DarkZeros/LightInk/hardware/case/CASE.md

# Case Design 

The case started from a reference case from: https://www.printables.com/model/502517-watchy-case-with-low-profile-buttons/collections
Thanks for that reference design!

I took it and edited on top:
  - Removed the screw holes
  - Shifted the display UP in order to have a even space in the border around display
    - This required removing the watchy PCB arches on top/bottom
  - Make a new square hole for the solar panel
  - Removed the buttons, instead add M1 holes for screws
  - Make more space inside the case by reducing the supports and the reducing size
  - Many other small changes

# Versions

I uploaded all the versions I have saved, though I recomend the V14 for production.
I have access to all the history in onShape. [OnShape Link](https://cad.onshape.com/documents/3c40abaf85090b07c79fcd27/w/1896b3b0cd361c4ac062c341/e/53d3942db51d4a936ae92a33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)

# Important things

The case needs to be UV resistent. If the material is not, then will quickly turn YELLOW.
I used SLA resin and Nylon, and those did not degrade, but other materials probably will.

(ADD picture here of how much it degrades to yellow)

## What is it?

It just tries to keep all the watch inside. Thats it. It doesn´t try to
be amazing or fancy. take it as reference, if you want you can build another one or edit in place small things.

# How to print

I used JLCPCB service to print, since I do not have a good enough 3D printed.
The order was: 
- SLA(Resin) 
- Imagine Black 
- Sanding general

Also I did try this other one for White colour:
- SLS(Nylon) 
- 1172Pro Nylon 
- White 
- No surface finish
