DarkZeros/LightInk/hardware/pcb/kicad/V5.kicad_pcb

## KiCad design hardware/pcb/kicad/V5.kicad_pcb (2026-11-06)

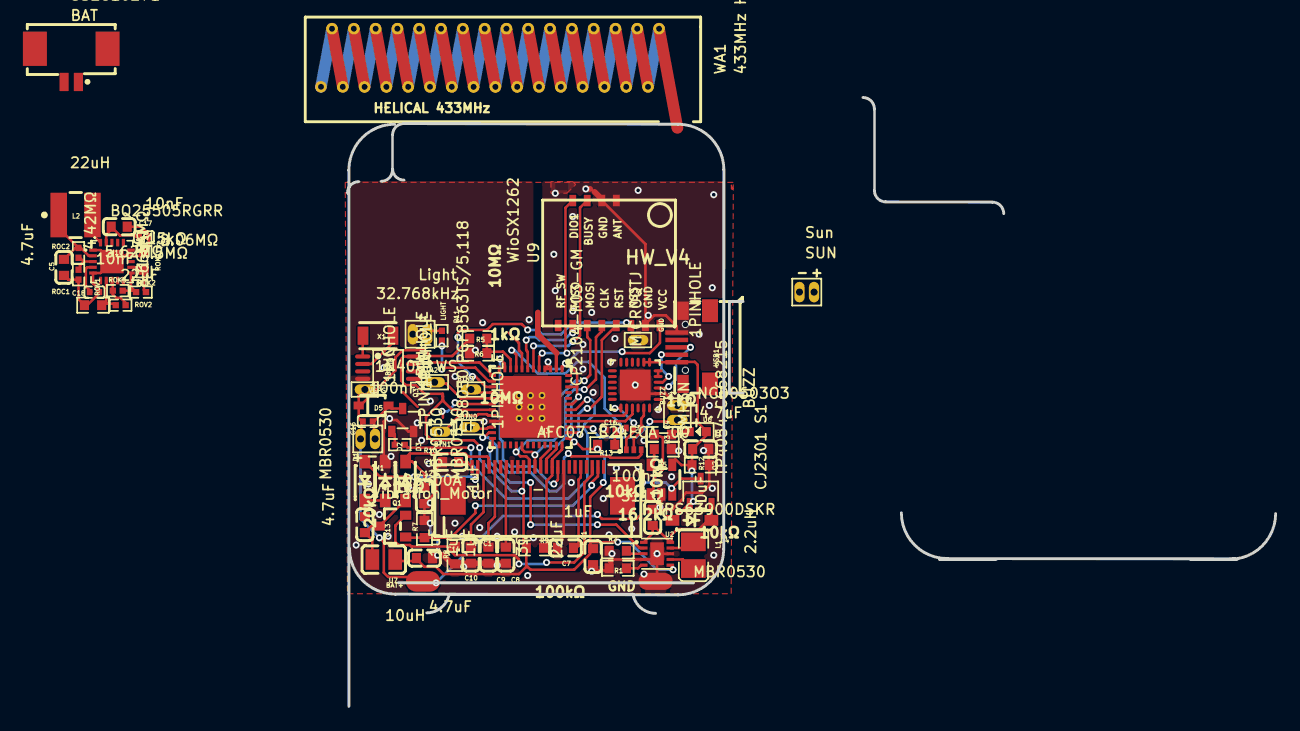
[picture p3: board V5.kicad_pcb from above]

Board: 2 copper layers, 81.1 x 53.2 mm, 75 parts (1 on the bottom side), 68 nets.

Parts:
+BAT: 1PINHOLE
AE1: SWRA117D
BAT: 532610271; CONN-SMD_532610271
BTN0, BTN1, BTN2, BTN3: 1PINHOLE
BUZZ: BUZZ; VIBRATING-MOTOR-SMD_WELDING
C1, C17: 22uF; C0603
C2: 10uF; C0603
C5, C6, C13, C14: 4.7uF; C0603
C7, C8, C9, C10, C11, C12: 1uF; C0603
C15, C16: 100nF; C0402
C18, C19: 10nF; C0402
D1, D2, D3, D4: MBR0530; SOD-123_L2.7-W1.6-LS3.7-RD-1
D5: 1N4001WS; SOD-323_L1.6-W1.3-LS2.7-RD
FPC1: AFC07-S24ECA-00; FPC-SMD_AFC07-S24ECA-00
GND: 1PINHOLE
L1: 2.2uH; L1008
L2: 22uH; IND-SMD_L3.9-W3.9-1
LIGHT: Light; VIBRATING-MOTOR-SMD_WELDING
M1: Vibration_Motor; VIBRATING-MOTOR-SMD_WELDING
Pad_gge46144: Pad_gge46144
Pad_gge46189: Pad_gge46189
Q1: AO3400A; SOT-23_L2.9-W1.3-P1.90-LS2.4-BR
Q2: CJ2301 S1; SOT-23-3_L3.0-W1.7-P0.95-LS2.9-BR
Q3: S8050; SOT-23-3_L2.9-W1.3-P1.90-LS2.4-BR
Q4: UMH3N; SC-70-6_L2.2-W1.3-P0.65-LS2.1-BR
R1: 16.2kΩ; R0603
R2: 511Ω; R0603
R3, R12, R13: 10kΩ; R0603
R4: 1kΩ; R0603
R5, R6: 10MΩ; R0603
R7: 20kΩ; R0603
R8: 3Ω; R0603
R9: 100kΩ; R0603
R10, R11: 1kΩ; R0402
ROC1: 8.66MΩ; R0402
ROC2: 1.54MΩ; R0402
ROK1: 4.42MΩ; R0603
ROK2: 8.06MΩ; R0402
ROK3: 715kΩ; R0402
ROV1: 5.62MΩ; R0603
ROV2: 7.5MΩ; R0402
SUN: Sun; VIBRATING-MOTOR-SMD_WELDING
U2: TPS63900DSKR; WSON-10_L2.5-W2.5-W0.50-TL-EP
U3: -; LGA-48_L7.0-W7.0-P0.50-BL-EP5.4
U4: CP2104-F03-GM; QFN-24_L4.0-W4.0-P0.50-BL-EP2.7
U5: TP4054_C668215; TSOT-23-5_L2.9-W1.6-P0.95-LS2.8-BR
U6: NCD0603O3; LED0603-RD
U7: 10uH; L0806
U8: PCF8563TS/5,118; TSSOP-8_L3.0-W3.0-P0.65-LS4.9-BL
U9: WioSX1262; SEEED_WIO_SX1262_PINS
U10: BQ25505RGRR; VQFN-20_L3.5-W3.5-P0.50-TL-EP
USB1: MICROQTJ; MICRO-USB-SMD_MICROQTJ
WA1: 433MHz Helical Antenna; 433MHZ HELICAL ANTENNA
X1: 32.768kHz; CRYSTAL-SMD_L3.2-W1.5

Connections:
32KHZ: U3.13, U8.7
+3V3: C1.2, C14.2, FPC1.9, FPC1.10, R9.2, R13.2, U2.6, U3.1, U3.3, U3.4, U3.19, U3.37, U3.43, U3.46, U7.1, U8.8, U9.8
+BAT: +BAT.1, BAT.1, C15.1, D5.1, M1.2, Pad_gge46189.2, Q2.3, R5.1, SUN.2, U5.3, U10.18
+SOL: C5.2, L2.1, ROC2.1, U10.2
AE1_1: AE1.1, U3.2
BAT: R5.2, R6.1, U3.10
BTN0: BTN0.1, U3.22
BTN1: BTN1.1, U3.20
BTN2: BTN2.1, U3.17
BTN3: BTN3.1, U3.16
BUSY: FPC1.16, U3.11
BUZZ: BUZZ.2, U3.39
C7_2: C7.2, FPC1.20
C8_2: C8.2, FPC1.7
C9_2: C9.2, FPC1.5
C10_2: C10.2, FPC1.3
C11_2: C11.2, FPC1.1
D1_1: C13.2, D1.1, D2.2
D3_2: C13.1, D3.2, Q1.3, U7.2
D+: U4.3, USB1.3
D-: U4.4, USB1.2
DC: FPC1.14, U3.35
DIO1: U3.5, U9.12
DTR: Q4.2, Q4.4, U4.23
EN: C16.1, Q4.6, R13.1, U3.9
GDR: FPC1.23, Q1.1, R7.1
GH: C12.1, D3.1, FPC1.4
GL: D1.2, FPC1.2
GND: AE1.2, BAT.2, BUZZ.1, C1.1, C2.1, C5.1, C6.2, C7.1, C8.1, C9.1, C10.1, C11.1, C12.2, C14.1, C16.2, C17.1, C18.2, C19.2, D2.1, FPC1.8, FPC1.17, GND.1, LIGHT.1, Pad_gge46144.2, Q3.2, R1.1, R2.1, R3.1, R6.2, R7.2, R8.2, R12.1, ROC1.2, ROK1.2, ROV1.1, SUN.1, U2.4, U2.8, U2.11, U3.21, U3.49, U4.2, U4.25, U5.2, U8.4, U9.7, U9.10, U10.1, U10.5, U10.14, U10.15, U10.21, USB1.5
GPIO0: Q4.3, U3.23
L2_2: L2.2, U10.20
LIGHT: R11.2, U3.14
LIGHT_2: LIGHT.2, R11.1
LORABUSY: U3.6, U9.11
LORACS: U3.15, U9.6
LORARES: U3.38, U9.5
MISO: U3.7, U9.2
MOSI: FPC1.11, U3.28, U9.3
Q3_1: Q3.1, R10.2
Q3_3: C15.2, D5.2, M1.1, Q3.3
R4_2: R4.2, U6.1
RES: FPC1.15, R9.1, U3.36
RESE: FPC1.22, Q1.2, R8.1
RTS: Q4.1, Q4.5, U4.19
RX: U3.40, U4.21
SCK: FPC1.12, U3.29, U9.4
SS: FPC1.13, U3.34
TX: U3.41, U4.20
U2_1: C2.2, D4.1, Q2.2, U2.1, U2.10
U2_3: R2.2, U2.3
U2_5: R1.2, U2.5
U2_7: L1.2, U2.7
U2_9: L1.1, U2.9
U4_5: U4.5, U4.6
U5_1: R4.1, U5.1
U5_5: R3.2, U5.5
U10_3: ROC1.1, ROC2.2, U10.3
U10_4: C18.1, U10.4
U10_7: ROV1.2, ROV2.1, U10.7
U10_8: ROK3.1, ROV2.2, U10.8
U10_11: ROK2.1, ROK3.2, U10.11
U10_12: ROK1.1, ROK2.2, U10.12
U10_19: C17.2, C19.1, U10.19
VBUS: C6.1, D4.2, Q2.1, R12.2, U4.7, U4.8, U5.4, U6.2, USB1.1
VIB: R10.1, U3.42
VSEL: U2.2, U3.24
XN: U8.2, X1.2
XP: U8.1, X1.1
