DarkZeros/LightInk/firmware/main/peripherals.cpp

#include "peripherals.h"
#include "hardware.h"
#include "notes.h"
#include "power.h"
#include "touch.h"
#include "trace.h"

#include <mutex>

#include "driver/gpio.h"
#include "Arduino.h"

void Peripherals::vibrator(const std::vector<int>& pattern) {
  constexpr const gpio_config_t kConf = {
    .pin_bit_mask = (1ULL<<HW::kVibratorPin),
    .mode = GPIO_MODE_OUTPUT,
    .pull_up_en = GPIO_PULLUP_DISABLE,
    .pull_down_en = GPIO_PULLDOWN_DISABLE,
    .intr_type = GPIO_INTR_DISABLE,
  };

  //Configure GPIO with the given settings
  gpio_config(&kConf);
  Trace::vibrator(pattern);

  for(auto i = 0; i < pattern.size(); i++) {
    gpio_set_level((gpio_num_t)HW::kVibratorPin, i % 2 ? 0 : 1);
    delay(pattern[i]);
  }
  gpio_set_level((gpio_num_t)HW::kVibratorPin, 0);
}

#include "driver/ledc.h"
#include "soc/ledc_struct.h"
#include "soc/rtc_cntl_reg.h"

struct Speaker {
  constexpr static auto kTimer = LEDC_TIMER_0;
  constexpr static auto kChannel = LEDC_CHANNEL_0;
  constexpr static auto kSpeedMode = LEDC_LOW_SPEED_MODE;
  constexpr static auto kClock = LEDC_USE_RC_FAST_CLK;

  // One sound at a time: a second Speaker would retune the timer of the first one and
  // stop it when it ends. A sound that starts meanwhile plays after it, like the beep
  // of a button and then what its action plays
  static inline std::mutex sPlaying;
  std::lock_guard<std::mutex> playing{sPlaying};

  Power::Lock powerLock = Power::Lock(Power::Flag::Speaker);

  // RC_FAST stays powered in light sleep (CK8M_FORCE_PU), but the RTC state machine still
  // gates it to the digital side for its 8M wait on every sleep transition. The LEDC then
  // stalls for ~0.1 ms and the tone clicks (pitch -1.3%, level -21% through a filter, in
  // a recording). IDF sets FORCE_NOGATING with FORCE_PU on C2/C3, not on ESP32/S3, and
  // never writes the bit there, so it holds while set. Counted, sounds can overlap
  struct NoClockGating {
    static inline std::atomic<int> sUsers{0};
    NoClockGating() {
      if (sUsers.fetch_add(1) == 0)
        SET_PERI_REG_MASK(RTC_CNTL_CLK_CONF_REG, RTC_CNTL_CK8M_FORCE_NOGATING);
    }
    ~NoClockGating() {
      if (sUsers.fetch_sub(1) == 1)
        CLEAR_PERI_REG_MASK(RTC_CNTL_CLK_CONF_REG, RTC_CNTL_CK8M_FORCE_NOGATING);
    }
  } noClockGating;

  // On the PICO-D4 the touch FSM measurement stalls the tone too, so touch is
  // measured in between notes, in the silence before each one starts (set())
  Touch::Manual touchManual;

  // Select resolution based on the frequency values, not to overflow or underflow divisor
  static ledc_timer_bit_t calc_resolution(uint32_t freq) {
    if (freq < 64) return LEDC_TIMER_10_BIT;
    if (freq < 128) return LEDC_TIMER_9_BIT;
    if (freq < 256) return LEDC_TIMER_8_BIT;
    if (freq < 512) return LEDC_TIMER_7_BIT;
    if (freq < 1024) return LEDC_TIMER_6_BIT;
    if (freq < 2 * 1024) return LEDC_TIMER_5_BIT;
    if (freq < 4 * 1024) return LEDC_TIMER_4_BIT;
    if (freq < 8 * 1024) return LEDC_TIMER_3_BIT;
    if (freq < 16 * 1024) return LEDC_TIMER_2_BIT;
    return LEDC_TIMER_1_BIT;
  }

  Speaker() {
    // Enable light sleep while Speaker active
    esp_sleep_pd_config(ESP_PD_DOMAIN_RC_FAST, ESP_PD_OPTION_ON);
    gpio_sleep_sel_dis((gpio_num_t)HW::kSpeakerPin);

    // Set up channel config, never changes
    constexpr ledc_channel_config_t ledc_channel = {
        .gpio_num = (gpio_num_t)HW::kSpeakerPin,
        .speed_mode = kSpeedMode,
        .channel = kChannel,
        .intr_type = LEDC_INTR_DISABLE,
        .timer_sel = kTimer,
        .duty = 0,
        .hpoint = 0,
        .sleep_mode = LEDC_SLEEP_MODE_KEEP_ALIVE,
        .flags = {
          .output_invert = 0,
        },
        .deconfigure = false,
    };
    ledc_channel_config(&ledc_channel);

    // ledc_timer_config_t ledc_timer = {
    //   .speed_mode = kSpeedMode,
    //   .duty_resolution = LEDC_TIMER_2_BIT, // calc_resolution(freq),
    //   .timer_num = kTimer,
    //   .freq_hz = 0, // Set output frequency
    //   .clk_cfg = kClock,
    //   .deconfigure = false,
    // };
    // ledc_timer_config(&ledc_timer);
  }
  ~Speaker() {
    stop();
    esp_sleep_pd_config(ESP_PD_DOMAIN_RC_FAST, ESP_PD_OPTION_AUTO);
  }

  void set(uint32_t freq) {
    if (freq == 0) {
      stop();
      return;
    }
    // Update timer + duty
    const auto dutyBit = calc_resolution(freq);
    uint32_t halfDuty = 1 << (dutyBit - 1);

    ledc_stop(kSpeedMode, kChannel, 0);  // Clear duty_start / sig_out_en first
    Touch::measureNow();                 // While silent, see touchManual

    ledc_timer_config_t ledc_timer = {
      .speed_mode = kSpeedMode,
      .duty_resolution = dutyBit,
      .timer_num = kTimer,
      .freq_hz = freq, // Set output frequency
      .clk_cfg = kClock,
      .deconfigure = false,
    };
    ledc_timer_config(&ledc_timer);

    // // ledc_set_freq(kSpeedMode, kTimer, freq);
    // ledc_set_duty(kSpeedMode, kChannel, halfDuty);
    // ledc_update_duty(kSpeedMode, kChannel);
    // // ledc_ls_channel_update(kSpeedMode, kChannel);
    // // ledc_hal_ls_channel_update(&(p_ledc_obj[kSpeedMode]->ledc_hal), channel);

    // // ledc_set_freq(kSpeedMode, kTimer, freq);
    // // ledc_set_duty_and_update(kSpeedMode, kChannel, halfDuty, 0);

    // Directly write registers, bypassing the duty_start spin-wait
    LEDC.channel_group[kSpeedMode].channel[kChannel].duty.duty = halfDuty << 4;
    LEDC.channel_group[kSpeedMode].channel[kChannel].conf0.sig_out_en = 1;
    LEDC.channel_group[kSpeedMode].channel[kChannel].conf1.duty_inc = 1;
    LEDC.channel_group[kSpeedMode].channel[kChannel].conf1.duty_num = 1;
    LEDC.channel_group[kSpeedMode].channel[kChannel].conf1.duty_cycle = 1;
    LEDC.channel_group[kSpeedMode].channel[kChannel].conf1.duty_scale = 0;
    // Trigger low-speed channel update (no spin-wait)
    LEDC.channel_group[kSpeedMode].channel[kChannel].conf0.low_speed_update = 1;
  }

  void stop() {
    ledc_stop(kSpeedMode, kChannel, 0);
  }
};

void Peripherals::speaker(const std::vector<std::pair<int, int>>& pattern) {
  Speaker speaker;
  Trace::speaker(pattern);

  for(auto& [note, duration] : pattern) {
    speaker.set(note);
    delay(duration);
  }
}



// change this to make the song slower or faster
int tempo=144; 

// change this to whichever pin you want to use
int buzzer = 11;

// notes of the moledy followed by the duration.
// a 4 means a quarter note, 8 an eighteenth , 16 sixteenth, so on
// !!negative numbers are used to represent dotted notes,
// so -4 means a dotted quarter note, that is, a quarter plus an eighteenth!!
int melody[] = {

  //Based on the arrangement at https://www.flutetunes.com/tunes.php?id=192
  
  NOTE_E5, 4,  NOTE_B4,8,  NOTE_C5,8,  NOTE_D5,4,  NOTE_C5,8,  NOTE_B4,8,
  NOTE_A4, 4,  NOTE_A4,8,  NOTE_C5,8,  NOTE_E5,4,  NOTE_D5,8,  NOTE_C5,8,
  NOTE_B4, -4,  NOTE_C5,8,  NOTE_D5,4,  NOTE_E5,4,
  NOTE_C5, 4,  NOTE_A4,4,  NOTE_A4,8,  NOTE_A4,4,  NOTE_B4,8,  NOTE_C5,8,

  NOTE_D5, -4,  NOTE_F5,8,  NOTE_A5,4,  NOTE_G5,8,  NOTE_F5,8,
  NOTE_E5, -4,  NOTE_C5,8,  NOTE_E5,4,  NOTE_D5,8,  NOTE_C5,8,
  NOTE_B4, 4,  NOTE_B4,8,  NOTE_C5,8,  NOTE_D5,4,  NOTE_E5,4,
  NOTE_C5, 4,  NOTE_A4,4,  NOTE_A4,4, REST, 4,

  NOTE_E5, 4,  NOTE_B4,8,  NOTE_C5,8,  NOTE_D5,4,  NOTE_C5,8,  NOTE_B4,8,
  NOTE_A4, 4,  NOTE_A4,8,  NOTE_C5,8,  NOTE_E5,4,  NOTE_D5,8,  NOTE_C5,8,
  NOTE_B4, -4,  NOTE_C5,8,  NOTE_D5,4,  NOTE_E5,4,
  NOTE_C5, 4,  NOTE_A4,4,  NOTE_A4,8,  NOTE_A4,4,  NOTE_B4,8,  NOTE_C5,8,

  NOTE_D5, -4,  NOTE_F5,8,  NOTE_A5,4,  NOTE_G5,8,  NOTE_F5,8,
  NOTE_E5, -4,  NOTE_C5,8,  NOTE_E5,4,  NOTE_D5,8,  NOTE_C5,8,
  NOTE_B4, 4,  NOTE_B4,8,  NOTE_C5,8,  NOTE_D5,4,  NOTE_E5,4,
  NOTE_C5, 4,  NOTE_A4,4,  NOTE_A4,4, REST, 4,
  

  NOTE_E5,2,  NOTE_C5,2,
  NOTE_D5,2,   NOTE_B4,2,
  NOTE_C5,2,   NOTE_A4,2,
  NOTE_GS4,2,  NOTE_B4,4,  REST,8, 
  NOTE_E5,2,   NOTE_C5,2,
  NOTE_D5,2,   NOTE_B4,2,
  NOTE_C5,4,   NOTE_E5,4,  NOTE_A5,2,
  NOTE_GS5,2,

};

// Cancel is only checked between notes: each wake in the middle of a note glitches it
// (light sleep exit and entry bend pitch and level for a few ms)
void Peripherals::tetris(const Cancel& cancel) {
  Speaker speaker;
  int notes=sizeof(melody)/sizeof(melody[0])/2; 

  // this calculates the duration of a whole note in ms (60s/tempo)*4 beats
  int wholenote = (60000 * 4) / tempo;

  int divider = 0, noteDuration = 0;
  for (int thisNote = 0; thisNote < notes * 2 && !cancel; thisNote = thisNote + 2) {

    // calculates the duration of each note
    divider = melody[thisNote + 1];
    if (divider > 0) {
      // regular note, just proceed
      noteDuration = (wholenote) / divider;
    } else if (divider < 0) {
      // dotted notes are represented with negative durations!!
      noteDuration = (wholenote) / abs(divider);
      noteDuration *= 1.5; // increases the duration in half for dotted notes
    }

    // we only play the note for 90% of the duration, leaving 10% as a pause
    speaker.set(melody[thisNote]);
    delay(noteDuration * 0.9);

    speaker.set(0);
    delay(noteDuration * 0.1);
  }
}
