DarkZeros/LightInk/firmware/main/icons.h

// 'battery', 37x21px
const unsigned char battery [] PROGMEM = {
	0x3f, 0xff, 0xff, 0xff, 0x80, 0x7f, 0xff, 0xff, 0xff, 0xc0, 0xff, 0xff, 0xff, 0xff, 0xe0, 0xe0,
	0x00, 0x00, 0x00, 0xe0, 0xe0, 0x00, 0x00, 0x00, 0xe0, 0xe0, 0x00, 0x00, 0x00, 0xf8, 0xe0, 0x00,
	0x00, 0x00, 0xf8, 0xe0, 0x00, 0x00, 0x00, 0x38, 0xe0, 0x00, 0x00, 0x00, 0x38, 0xe0, 0x00, 0x00,
	0x00, 0x38, 0xe0, 0x00, 0x00, 0x00, 0x38, 0xe0, 0x00, 0x00, 0x00, 0x38, 0xe0, 0x00, 0x00, 0x00,
	0x38, 0xe0, 0x00, 0x00, 0x00, 0x38, 0xe0, 0x00, 0x00, 0x00, 0xf8, 0xe0, 0x00, 0x00, 0x00, 0xf8,
	0xe0, 0x00, 0x00, 0x00, 0xe0, 0xe0, 0x00, 0x00, 0x00, 0xe0, 0xff, 0xff, 0xff, 0xff, 0xe0, 0x7f,
	0xff, 0xff, 0xff, 0xc0, 0x3f, 0xff, 0xff, 0xff, 0x80
};
// 'bluetooth', 13x21px
const unsigned char bluetooth [] PROGMEM = {
	0x1f, 0xc0, 0x3f, 0xe0, 0x7f, 0xf0, 0xfd, 0xf8, 0xfc, 0xf8, 0xfc, 0x78, 0xdd, 0x38, 0xcd, 0x98,
	0xe5, 0x38, 0xf0, 0x78, 0xf8, 0xf8, 0xf8, 0xf8, 0xf0, 0x78, 0xe5, 0x38, 0xcd, 0x98, 0xfd, 0x38,
	0xfc, 0x78, 0xfc, 0xf8, 0x7d, 0xf0, 0x3f, 0xe0, 0x1f, 0xc0
};
// 'celsius', 26x20px
const unsigned char celsius [] PROGMEM = {
	0x3f, 0x80, 0x1f, 0xc0, 0x7f, 0xc0, 0x3f, 0xc0, 0xc0, 0x60, 0x60, 0x00, 0xc0, 0x60, 0x60, 0x00,
	0xc0, 0x60, 0x60, 0x00, 0xc0, 0x60, 0x60, 0x00, 0xc0, 0x60, 0x60, 0x00, 0xc0, 0x60, 0x60, 0x00,
	0xc0, 0x60, 0x60, 0x00, 0xff, 0xc0, 0x40, 0x00, 0x7f, 0x80, 0x00, 0x00, 0x00, 0x00, 0x60, 0x00,
	0x00, 0x00, 0x60, 0x00, 0x00, 0x00, 0x60, 0x00, 0x00, 0x00, 0x60, 0x00, 0x00, 0x00, 0x60, 0x00,
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
};


// #include "comp.h"

// constexpr std::array input = {0x12, 0x34, 0x56};
// static_assert(RLE1B<input>::view.size() == 3);


// static_assert(RLE1B<wifioff2>::view.size() == wifioff2.size());

// static_assert(RLETestA<wifioff2>::view.size() == wifioff2.size());
