DarkZeros/LightInk/firmware/main/touch.cpp

#include "touch.h"
#include "deep_sleep.h"
#include "power.h"

#include "soc/rtc.h"

#include "hal/touch_sensor_legacy_hal.h"
#include "driver/touch_sensor.h"
#include "esp_sleep.h"
#include "esp_timer.h"

#include <atomic>
#include <optional>

namespace {
  RTC_DATA_ATTR bool mInitialized {false};
  // Last configuration applied to the HW, to skip redundant setups
  struct Applied {
    bool onlyMenuLight;
    MeasureCycles cycles;
    MeasureRate rate;
    int8_t sensitivity;
    std::array<uint8_t, 4> map;
    bool operator==(const Applied&) const = default;
  };
  RTC_DATA_ATTR std::optional<Applied> mApplied {};

  // Time between two timer measurements at a rate, _1s is one second
  constexpr uint32_t intervalMs(MeasureRate rate) { return rate * 1000 / MeasureRate::_1s; }
};

Touch::Touch(TouchSettings& settings) : mSettings{settings} {
};

void Touch::initialize() {
  touch_pad_init();
  touch_pad_set_voltage(TOUCH_HVOLT_2V4, TOUCH_LVOLT_0V5, TOUCH_HVOLT_ATTEN_1V);

  // Touching increases "C" reducing the measure
  // touch_pad_set_trigger_mode(TOUCH_TRIGGER_BELOW); // By default
  // touch_pad_intr_enable();
  // touch_pad_denoise_disable();
  touch_pad_set_fsm_mode(TOUCH_FSM_MODE_TIMER);
#if (HW_VERSION >= 10)
  touch_pad_fsm_start();
#endif

  for (auto p : HW::Touch::Pad) {
    auto pad = (touch_pad_t)p;
#if(HW_VERSION < 10)
    touch_pad_config(pad, 0);
#else
    touch_pad_config(pad);
    touch_ll_set_threshold(pad, 100000);
    touch_pad_sleep_channel_enable(pad, false); // We should not set sleep pads
#endif
  }
}

void Touch::setUp(bool onlyMenuLight) {
  if (!mInitialized) {
    mInitialized = true;
    initialize();
  }
#if(HW_VERSION >= 10)
  esp_sleep_pd_config(ESP_PD_DOMAIN_RTC_PERIPH, ESP_PD_OPTION_ON);
#endif

  const auto rate = mSettings.mRate[onlyMenuLight];
  const Applied applied{onlyMenuLight, mSettings.mCycles[onlyMenuLight], rate, mSettings.mSensitivity, mSettings.mMap};
  if (mApplied == applied)
    return;
  mApplied = applied;

#if(HW_VERSION < 10)
  touch_ll_set_meas_time(mSettings.mCycles[onlyMenuLight] * 1024);
  touch_pad_set_measurement_interval(intervalMs(rate) * 32768 / 1000); // RTC slow cycles
#else
  touch_ll_set_meas_times(mSettings.mCycles[onlyMenuLight] * 1024);
  touch_pad_set_measurement_interval((4 * 1024) / MeasureRate::_1s * rate); //???
#endif

  auto setTouchPad = [&](auto&& v, bool enabled) {
    auto pad = (touch_pad_t)HW::Touch::Pad[mSettings.mMap[v]];
#if(HW_VERSION < 10)
    // The count grows with the measure time, so the threshold scales with it. The
    // sensitivity is for one cycle unit (_31ms). The rate does not change the count
    uint16_t th = enabled ? mSettings.mSensitivity * mSettings.mCycles[onlyMenuLight] : 0;
    touch_pad_clear_group_mask((1 << pad), (1 << pad), (1 << pad));
    if (enabled)
       touch_pad_set_group_mask((1 << pad), (1 << pad), (1 << pad));
#else
    uint16_t th = enabled ? 100 : 1000000;
#endif
    touch_ll_set_threshold(pad, th);
    // ESP_LOGE("setup", "%d, %d", pad, th);
  };
  setTouchPad(HW::Touch::BotR, !onlyMenuLight);
  setTouchPad(HW::Touch::TopR, !onlyMenuLight); 
  setTouchPad(HW::Touch::TopL, true);
  setTouchPad(HW::Touch::BotL, true);

  kDSState.lightPad = HW::Touch::Pad[mSettings.mMap[HW::Touch::BotL]];
}

namespace {
  std::atomic<int> sManualUsers{0};
  std::atomic<uint32_t> sLastMeasureMs{0};

  uint32_t nowMs() { return esp_timer_get_time() / 1000; }
  // Interval of the rate setUp() applied, measureNow() keeps to it. 0 before any setUp()
  uint32_t appliedIntervalMs() { return mApplied ? intervalMs(mApplied->rate) : 0; }
}

Touch::Manual::Manual() {
#if (HW_VERSION < 10)
  // The driver call, not the LL one: on ESP32 it also stops the touch timer
  // (touch_slp_timer_en). With only the mode switched the timer kept firing and each
  // tick still stalled the tone
  if (sManualUsers.fetch_add(1) == 0) {
    touch_pad_set_fsm_mode(TOUCH_FSM_MODE_SW);
    sLastMeasureMs = nowMs() - appliedIntervalMs(); // The first measureNow() measures
  }
#endif
}

Touch::Manual::~Manual() {
#if (HW_VERSION < 10)
  if (sManualUsers.fetch_sub(1) == 1)
    touch_pad_set_fsm_mode(TOUCH_FSM_MODE_TIMER); // Restarts the timer too
#endif
}

void Touch::measureNow() {
#if (HW_VERSION < 10)
  if (sManualUsers == 0)
    return;
  // Not more often than the timer would, short notes would pay ~0.6 ms each
  const uint32_t now = nowMs();
  if (now - sLastMeasureMs < appliedIntervalMs())
    return;
  sLastMeasureMs = now;
  touch_ll_start_sw_meas();
  // Done drops once the measurement starts and rises at its end, all pads take ~0.6 ms
  const auto start = esp_timer_get_time();
  while (touch_ll_is_measure_done() && esp_timer_get_time() - start < 100) {}
  while (!touch_ll_is_measure_done() && esp_timer_get_time() - start < 5000) {}
#endif
}

void Touch::enable() const {
  esp_sleep_enable_touchpad_wakeup();
}

void Touch::disable() const {
  esp_sleep_disable_wakeup_source(ESP_SLEEP_WAKEUP_TOUCHPAD);
}

Touch::Btn Touch::read() const {
  uint32_t mask = touchTriggerMask();
  // ESP_LOGE("mask", "%lu", mask);

  // Strange, but For S3 if the mask is unset, it is the last-pad
  if constexpr (HW::kChipType == HW_chips::ESP_32_S3) {
    if (mask == 0) {
      mask = 1 << HW::Touch::Pad.back();
    }
  }
  return toBtn(mask);
}

Touch::Btn Touch::toBtn(uint32_t mask) const {
  uint8_t bitmask {};
  for (auto i = 0; i < HW::Touch::Pad.size(); i++)
  {
    auto pad = HW::Touch::Pad[mSettings.mMap[i]];
    // uint16_t padLevel = touch_ll_read_raw_data((touch_pad_t)pad);
    // ESP_LOGE("val", "P%d; %d: %d", Power::current(), pad, padLevel);
    bitmask |= ((mask >> pad) & 1) << i;
  }
  return (Touch::Btn)bitmask;
}

std::vector<uint16_t> Touch::readAll() const {
  std::vector<uint16_t> res;
  for (auto i = 0; i < HW::Touch::Pad.size(); i++)
  {
    auto pad = HW::Touch::Pad[mSettings.mMap[i]];
    res.emplace_back(touch_ll_read_raw_data((touch_pad_t)pad));
  }
  return res;
}

void Touch::clear() const {
  touch_ll_clear_trigger_status_mask();
}

Touch::Btn Touch::readAndClear() const {
  auto btn = read();
  clear();
  return btn;
}

Touch::Btn Touch::poll() const {
  auto btn = toBtn(touchTriggerMask());
  clear();
  return btn;
}
