DarkZeros/LightInk/firmware/main/uspi.cpp

#include "uspi.h"
#include "trace.h"

namespace uSpi {
  static constexpr auto clockDiv = 266241; // =20MHz
  static constexpr auto clockDivOver = 8193; // =26MHz

  static spi_dev_t& dev = *(reinterpret_cast<volatile spi_dev_t *>(DR_REG_SPI3_BASE));

  void init(bool overdrive) {
    // Initialize all to 0
    memset((void*)&dev, 0, sizeof(dev));

    // Set
    dev.clock.val = overdrive ? clockDivOver : clockDiv;
    dev.user.usr_mosi = 1; // By default, enable the MISO step
    dev.user.usr_miso = 0; // We do not want to read anything
    dev.user.doutdin = 1;
    dev.user.cs_setup = 1;
    dev.user.cs_hold = 1;

    // Mode 0
    dev.user.ck_out_edge = 0;
    dev.ctrl.wr_bit_order = 0; //MSBFIRST
    dev.ctrl.rd_bit_order = 0;

    gpio_mode_output<HW::Display::Dc>();
    gpio_mode_output<HW::Spi::Sck>(); // NEEDED FOR HW_V3
    gpio_mode_output<HW::Spi::Mosi>(); // NEEDED FOR HW_V3

#if (HW_VERSION < 10)
    rom_gpio_matrix_out(HW::Spi::Sck, VSPICLK_OUT_IDX, false, false);
    rom_gpio_matrix_out(HW::Spi::Mosi, VSPID_IN_IDX, false, false);
    rom_gpio_matrix_out(HW::Display::Cs, VSPICS0_OUT_IDX, false, false);
    dev.pin.val = dev.pin.val & ~((1 << 0) & SPI_SS_MASK_ALL);
#else
    dev.clk_gate.clk_en = 1;
    dev.clk_gate.mst_clk_sel = 1;
    dev.clk_gate.mst_clk_active = 1;
    dev.dma_conf.rx_afifo_rst = 1;
    dev.dma_conf.buf_afifo_rst = 1;
    dev.dma_conf.tx_seg_trans_clr_en = 1;
    dev.dma_conf.rx_seg_trans_clr_en = 1;

    // These pins need to be set as GPIO before can be used in the matrix
    if constexpr (HW::Spi::Sck == 19 || HW::Spi::Mosi == 19 || HW::Display::Cs == 19)
      gpio_ll_func_sel(&GPIO, 19, PIN_FUNC_GPIO);
    if constexpr (HW::Spi::Sck == 20 || HW::Spi::Mosi == 20 || HW::Display::Cs == 20)
      gpio_ll_func_sel(&GPIO, 20, PIN_FUNC_GPIO);

    rom_gpio_matrix_out(HW::Spi::Sck, SPI3_CLK_OUT_IDX, false, false);
    rom_gpio_matrix_out(HW::Spi::Mosi, SPI3_D_IN_IDX, false, false);
    rom_gpio_matrix_out(HW::Display::Cs, SPI3_CS0_OUT_IDX, false, false);
    dev.misc.val = dev.misc.val & ~((1 << 0) & SPI_SS_MASK_ALL);

    // Update the HW
    dev.cmd.update = 1;
    while (dev.cmd.update);
#endif
  }

  inline void submitUsrCommand() {
    #if !defined(CONFIG_IDF_TARGET_ESP32) && !defined(CONFIG_IDF_TARGET_ESP32S2)
      dev.cmd.update = 1;
      while (dev.cmd.update);
    #endif
    dev.cmd.usr = 1; // Submit command
  }

  inline void waitUsrDone() {
    while (dev.cmd.usr);
  }

  inline void writeMosiByteLen(uint32_t bytes) {
#if CONFIG_IDF_TARGET_ESP32S2 || CONFIG_IDF_TARGET_ESP32
    dev.mosi_dlen.usr_mosi_dbitlen = (bytes * 8) - 1;
#else
    dev.ms_dlen.ms_data_bitlen = (bytes * 8) - 1;
#endif
  }

  void write(const void *data_in, uint32_t len) {
    Trace::spi(data_in, len);
    uint32_t *data = (uint32_t *)data_in;

    while (len) {
      // Up to 64 bytes each transfer, if we write more it would loop
      auto c_len = (len > 64) ? 64 : len;
      auto longs = (c_len + 3) >> 2;

      writeMosiByteLen(c_len);

      // Write the buffer
      for (size_t i = 0; i < longs; i++) {
        dev.data_buf[i] = data[i];
      }
      submitUsrCommand();

      data += longs;
      len -= c_len;

      // Wait after variables update
      waitUsrDone();
    }
  }

  void write(const uint8_t data_in) {
    write(&data_in, 1);
  }

  void command(uint8_t value)
  {
    GPIO_OUTPUT_SET(HW::Display::Dc, 0);
    write(value);
    GPIO_OUTPUT_SET(HW::Display::Dc, 1);
  }

  void setRamArea(uint8_t x, uint8_t y, uint8_t w, uint8_t h) {
    // 180 degrees in hardware: the window from its start corner (see ramWindow)
    const auto [xs, xe, ys, ye] = ramWindow(getHwFlip(), x, y, w, h);
    command(0x44);  // X start & end positions (Byte)
    write(xs);
    write(xe);
    command(0x45); // Y start & end positions (Line)
    write(ys);
    write(0);
    write(ye);
    //write(0); // No need to write this, default is 0
    command(0x4e); // X start counter
    write(xs);
    command(0x4f); // Y start counter
    write(ys);
    //write(0); // No need to write this, default is 0
  };

  void writeArea(const uint8_t* ptr, uint8_t x, uint8_t y, uint8_t w, uint8_t h) {
    // Both banks only when a full refresh would show the back one (T76/T77)
    const int rams = getRamWrites();
    for (int ram = 0; ram < rams; ram++) {
      setRamArea(x, y, w, h);
      command(ram ? 0x26 : 0x24);
      write(ptr, ((uint16_t)h) * w / 8);
    }
  }

  void refresh() {
    // Set partial mode ? It should be already set, don't touch it
    // command(0x22);
    // write(0b11010100 | 0b00001000);
    // Update
    command(0x20);
    countRefresh(getSetDisplayMode() == FULL);
  }

  void hibernate() {
      // Sleep
      command(0x10);
      write(1);
  }
};
