DarkZeros/LightInk/(commit log)

2026-03-01 Touch fixes for phantom touch
    * Fixed by setting the touch after touch events
    This allows enough time for events to settle
    * Enable touch trigger at the end, avoids issues
    * Also cache the touch mode to avoid resetting
    [core.cpp, touch.cpp, touch.h]
2026-03-01 Allow to disable LowVoltage
    * Display has slightly less quality
    using low voltage
2026-03-01 Updated IDF 5.5.1 + Arduino 3.3.5
    - 911kB (Arduino 3.3 + IDF 5.5)
    - 934kB (Arduino 3.3.5 + IDF 5.5)
    - 938kB (Arduino 3.3.5 + IDF 5.5.1)
2026-03-01 Track display changes
2026-04-12 Rework the DateTime menu
    * Allow to underflow properly
    * Propagate the change back to other values
    ie: 01h00m00s -1s = 00h59m59s
    [ui.cpp]
2026-04-12 Wifi multiAP and NTP fixes
    * Allow multiAP wifi secrets
    * NTP gets location as well for setting sun without GPS
    [partitions.csv]
2026-04-12 Found out quality in display issue
    * Culprit is Booster time adjustments
    Need to pinpoint power usage and benefits...
    * Maybe create an option, low quality high quality...
    * TODO meadure costs!!
    [core.cpp, display.cpp, display.h]
2026-04-12 More display optimizations
    * Replace /% with >> and &
    [display.cpp]
2026-04-19 TRACE added WIP
2026-04-19 WIP Fixed rendering on the new code
    * Still not stable
    [core.cpp, display.cpp, hardware.h]
2026-04-29 WIP ADC Bat
2026-05-02 Refactor uSPI
    * Separate to cpp to be usable in multiple places
    * Fix minor things in display code to point to
    single SPI unit, thn allow to be uSPI or SPI.
    [deep_sleep.cpp, deep_sleep_utils.h, display.cpp, display.h, uspi.cpp, uspi.h]
2026-05-14 Optimize uSPI transfer
    * Reduced the typical case -4% the time
    *
2026-05-14 Fix timezone setting
    * Simplified the code and removed old NTP code
    The new one works better.
    * Use less network as well, by reducing the parameters
    * Reduced size by 45kB !
    [core.cpp, core.h]
2026-05-20 Fix GPS staying on
    [core.cpp]
2026-10-07 Turn WiFi off on all NTPSync exit paths
    On WiFi or NTP failure the function returned with the radio still on,
    and the power lock then dropped the rail to low voltage while WiFi
    was active, which can brown out the chip.
2026-10-07 Turn GPS off if location is obtained by other means
    The GPS polling task only runs while there is no location, so if the
    location was set elsewhere (e.g. NTP sync from the menu while GPS was
    on) the GPS stayed powered forever, together with the high voltage lock.
2026-11-06 Fix race between concurrent Power lock/unlock
    Updating the lock mask and writing the voltage pin were two separate
    steps, so a lock and an unlock from different tasks or cores could
    leave the rail low while a lock was held, or let lock() return before
    the rail was high. Both now happen inside Power::Critical.
    The RTC hold registers are shared between pins, so all hold changes
    now go through Power::hold(), which also replaces the copies of that
    code in Power::set() and Light::set().
    Critical needs no OS or setup, so the wake stub uses it unchanged. It
    disables interrupts and uses Peterson's lock between cores, because
    S32C1I lost about a third of updates on RTC memory on device.
    Co-Authore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
2026-11-06 Re-apply touch setup when any touch setting changes
    Touch::setUp() skipped everything when the measure rate was unchanged.
    With equal Menu/Watch rates, switching between watchface and menus never
    updated the enabled pads, leaving all pads as wake sources on the
    watchface (extra full wakeups). Sensitivity, cycles and pad mapping
    changes were also ignored until the rate changed.
2026-11-06 Filter touch trigger mask by wakeup-enabled pads in the app
    Moves the ESP-IDF touch_sensor_ll.h hotfix (masking touch_meas_en with
    touch_pad_worken) into an app helper used by both the main code and the
    wake stub, so the ESP-IDF fork patch is no longer needed.
2026-11-06 Enable display busy ext0 wakeup from the wake stub
    ESP-IDF rejects ext0 together with touch wakeup on ESP32, although per
    its docs this is only a limitation of chip revisions 0 and 1. Instead of
    patching ESP-IDF, the main code only configures the BUSY pin for ext0
    and the wake stub sets/clears the ext0 enable bit around the display
    refresh. This also avoids keeping ext0 armed after the refresh is done,
    where an idle (low) BUSY line would wake the chip again.
2026-11-06 Add Kicad project and EasyEDA backups
2026-11-06 Power measure captures
2026-11-06 trace: debug UART trace of display, power, WiFi and wakes, with a viewer
    Debug only (CONFIG_LIGHTINK_TRACE, off by default): binary frames on UART0
    with device timestamps:
    - Every display byte from the app and the wake stub.
    - Wakes and sleeps with a status snapshot (on-time, power locks, rail,
    WiFi/BT state, battery), power locks, peripherals, touches, WiFi, NTP.
    - Scripted touches (CONFIG_LIGHTINK_TRACE_SCRIPT) to drive the menus.
    Robustness: the writer lives in RTC fast memory for the stub and flash for
    the app; it forces UART0 out of XOFF and drops the frame instead of hanging;
    a hidden Power::Trace lock keeps the rail high while awake (HW v4 at 1.9 V
    slips UART bits).
    Viewer, tools/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
2026-11-06 display_test: SSD1681 experiment mode (T01-T86)
    Debug only (CONFIG_LIGHTINK_DISPLAY_TEST, off by default): replaces the
    watch app with a menu of display-controller experiments, each leaving a
    picture that answers one question the datasheet leaves open: RAM swap or
    copy per update type, counters, windows and entry modes, what survives
    sleep/reset, 0x21/0x37/0x01 options, border, BUSY timing, same-colour
    waveforms, band refresh, which bank a full refresh shows, what it leaves
    in the RAM, and which no-display updates swap.
    Sequences in docs/display_tests.md, results in docs/display_findings.md.
    UP/DOWN select, MENU runs, BACK returns. Holds a no-light-sleep lock while
    awake (UART0 XOFF) and cl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
2026-11-06 docs: SSD1681 findings from the on-panel experiments
    Results of T01-T86 with the user's answers verbatim, a working model of
    the controller, BUSY timings and what the driver does with it:
    - Two RAM banks with their own counters. Partial updates swap them; a full
    refresh doesn't, and shows the front buffer iff an even number of
    partials ran since the last full refresh or SWRESET.
    - Without the display bit only mode 2 + LUT load swaps: 0xD8 (92 ms) and
    0x98 (1 ms). Any 0x37 write stops full refreshes until SWRESET.
    - Partials drive back -> front and push unchanged pixels weakly.
    - HW reset after deep sleep mode 1 keeps everything; SWRESET clears RAM
    and needs 0x1A again; deep sleep mod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
2026-11-06 display: correct refresh-mode switching and full refreshes
    Measured on the panel (docs/display_findings.md):
    - A partial refresh swaps the RAM banks, a full one doesn't (T80): after
    it the front buffer holds the glass. It shows the front buffer iff an
    even number of partials ran since the last full refresh or SWRESET.
    - FULL mode writes the front buffer only, both banks after an odd number
    of partials. The parity is kept in RTC state, app and wake stub.
    - Before the first partial after a full refresh, swap with 0x22 = 0x98
    (1 ms, T86). It replaces the old update on every mode change (0xD8
    took 92 ms; 0xC8 and 0xD0 don't swap).
    - After a full refresh the watchface and wake stub skip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
2026-11-06 display: every rotation in hardware
    Adafruit-GFX always draws at rotation 0 and the display controller rotates
    while it writes (docs/display_findings.md T27, T52; checked on the watch
    for 0/90/180/270 degrees):
    - The entry mode mirrors X for 90/180 and Y for 180/270 (0x11 = 03, 02,
    00, 01), bits included, and the RAM window starts at its corner. One
    inline function, ramWindow(), maps a buffer rect to that window for the
    app driver (_setRamArea) and the wake stub (uSpi::setRamArea).
    - The controller can't transpose bits (a RAM byte is always 8 horizontal
    pixels), so for 90/270 the buffer holds the transposed picture:
    drawPixel swaps x/y, the fast line helpers swap H/V and toBuffer()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
2026-11-06 core: turn WiFi off on every NTPSync() exit
    When syncTime() timed out, NTPSync() returned before WiFi.disconnect(true)
    and left the radio running for the rest of the wake, after its power lock
    (and the rail) had been released. Found by the trace: first boot showed
    WIFI GOT IP, no NTP sync, UNLOCK WiFi, and no WIFI STOP before sleep. A
    scope guard now disconnects on every path, before the lock is released.
2026-11-06 display: drop 90/270 rotation, keep 0/180 in hardware
    Only 0 and 180 degrees are useful on the watch. With 90/270 gone the
    buffer is never transposed, so:
    - drawPixel and the fast line helpers lose the per-pixel rotation check,
    and the raw line helpers fold into them (3.5% faster than keeping them
    separate, and less code).
    - toBuffer() is gone, alignRect() only aligns.
    - The rotation setting becomes a bool, mFlip ("Flip 180" in the menu),
    and setFlip() sets entry mode 03 or 00. ramWindow() takes the flag.
    - The watchface cache no longer depends on the orientation: the controller
    does the flip, so the cached buffer bytes are the same either way.
    Measured on the watch (esp32, HW v4):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
2026-11-06 hardware: stop tracking KiCad's .history repo
    KiCad keeps its local history as a nested git repo, and the Kicad import
    committed it as a gitlink with no .gitmodules entry. Every recursive
    submodule command then fails on a fresh clone. Ignore it, it stays on disk.
2026-11-06 firmware: update to ESP-IDF v6.1 and Arduino core 4.0
    - esp-idf: new lightmyink_v6.1 branch, v6.1 plus the five local patches
    - arduino-esp32 4.0.0-rc1, building only the libraries we use
    - Picolibc is now the libc: include sys/time.h for timeval and give
    TimeLib.h the guard it expects, drop the Newlib nano format option
    - Follow the moved HAL headers, the rom_gpio_* renames and the new
    LEDC field. Wake causes now come as a mask, keep the old priority
    - Keep two 5.x settings: FreeRTOS in IRAM and default warnings not errors
    - Global constructors now run through __libc_init_array in a new order:
    give the RTC pad descriptors init_priority(101), the trace reached
    Power::set() before des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
2026-11-06 components: update the libraries to their latest releases
    - ArduinoJson 7.4.3, Adafruit GFX 1.13.0, BusIO 1.17.4, magic_enum 0.9.8,
    RadioLib 7.8.1, fmt 12.2.0, NTPClient to current master
    - RadioLib: glob the sources, the list had gone stale
    - WiFiManager: lightmyink_v6 is upstream master plus our print fix. Point
    the submodule at the fork, the pinned commit is not in tzapu's repo
2026-11-07 core: keep RTC_PERIPH on for the display BUSY wakeup
    The wake stub arms ext0 itself, so IDF never sees it in its triggers and
    powers RTC_PERIPH off when only touch is armed. ext0 then never fires, the
    display is not hibernated until the next timer wake and the picture fades
    with the analog left on, with the rail held high meanwhile.
    Request the domain explicitly, after the AUTO reset. This needs no IDF
    change and gives the same power state as arming ext0 through IDF.
2026-11-07 radio: only arm the DIO1 wakeup while listening
    Track the receive state across deep sleep, set by startReceive() and
    cleared by sleep(). With the radio off nothing can arrive, so don't arm
    ext1 at all.
2026-11-07 deep_sleep: wake on display BUSY through ext1
    ext0 lives in RTC IO, so it needs RTC_PERIPH powered for the whole sleep.
    ext1 is in the RTC controller and works with it off, so stop forcing it on
    and leave touch running in IDF's default state.
    Core sets up and holds the BUSY pad, the display releases it at boot. The
    stub points ext1 at BUSY only during a refresh, then back to DIO1 if the
    radio is listening, or disarms it. ext0 is not used anymore.
2026-11-07 build: remove the warnings and use two OTA slots
    - main: make the compile options PRIVATE, -Wno-volatile leaked into the C
    file IDF generates for the ELF
    - partitions: replace factory + ota_1 with ota_0 + ota_1 of 1.5M each. OTA
    could not work without ota_0, and the app overflowed the 1M ota_1. nvs
    stays in place and ota_0 starts where factory did
    - sdkconfig: drop the ESP-IDF 5.4 headers from the defaults
2026-11-07 gps: don't enable the RX pull-up on the input-only pad
    Arduino's UART pulls RX up by default, and GPIO 39 has no pull-up, so
    every GPS read logged a gpio_pullup_en error. The GPS drives the line.
2026-11-08 ui: put every frame on the panel from Core::draw()
    UI elements now only draw into the buffer. Core::draw() prepares the
    display, composes the screen, refreshes once and hibernates, and it can
    run more than once per wake:
    - Display::wake() leaves hibernate for a further frame in the same wake.
    The hibernated flag is in the RTC display state, since the panel stays
    asleep across ESP deep sleeps. The datasheet's 10 ms + BUSY wait after
    the HW reset stays commented out: the constructor and the wake stub
    never needed it
    - waitWhileBusy() enables the BUSY interrupt only once its handler is in:
    after wake() BUSY is already low, and the level interrupt fired forever
    - the buffer and cursor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
2026-11-08 ui: add popups, use them for NTP and the sound tests
    A popup is a message box that Core::draw() adds on top of the menus or
    the watchface. It survives deep sleep until a button removes it, or the
    watchdog when it leaves the menus:
    - kSettings.mUi.popup() sets a final message for the end of wake draw
    - Core::progress() draws a step of blocking work right away
    - Core::runCancellable() runs a job under a popup, BACK cancels it
    - on the watchface every frame with a popup is a full one, and so is the
    one after it. The wake stub stays off meanwhile, each update is a boot
    - the watchface only draws a full frame into the buffer, Core::draw()
    writes and refreshes it. Partial updates stay in the w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
2026-11-08 trace: emit power events outside Power::Critical
    The app trace locks stdout, and a recursive mutex aborts when taken with
    interrupts off, so every trace build crashed in a boot loop. Lock and
    unlock now read the mask and rail inside Critical and trace them after.
2026-11-08 trace viewer: continue a command whose data arrives late
    The live viewer closes a command after 0.3 s without input, and a slow
    redraw was enough to split a 0x24 from its 5000 B of data. The frame was
    then never written to the model, so the panel view showed the previous
    frame or a black screen. Data with no open command now continues the last
    command: a RAM write goes on at the counters, and a register command is
    set again with all its parameters so far. A corrupt frame or a new wake
    ends this.
2026-11-08 cancel: check BACK only when the job is awake
    runCancellable woke the chip every 50 ms to poll touch, and Tetris woke
    every 50 ms to check cancel. Each light sleep exit and entry bends a
    playing tone (pitch -0.7%, level -25% for a few ms), heard as a choppy
    note, and the wakes cost power.
    - Cancel is a class: a flag plus an optional check run on each read.
    runCancellable sets it to a touch poll for BACK and just waits. The
    touch status latches, so a press made while the job slept is seen.
    - Tetris checks cancel once per note instead of every 50 ms.
    Claude-Session: https://claude.ai/code/session_01BiywnG8XrhUJbybvmrCbWy
2026-11-08 speaker: keep RC_FAST ungated through light sleep transitions
    RC_FAST stays powered in light sleep, but the RTC state machine still
    gates it to the digital side during its 8M wait on each transition
    (4 slow cycles, ~120 us). The LEDC stalls and the tone clicks at every
    wake. IDF sets CK8M_FORCE_NOGATING together with FORCE_PU on C2/C3 but
    not on ESP32/S3, and never writes the bit there, so Speaker sets it
    while any sound plays (counted) and clears it after.
    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
2026-11-09 speaker: measure touch between notes, not with the touch FSM timer
    On the PICO-D4 every touch FSM measurement stalls RC_FAST, and so the
    playing tone, for up to ~0.1 ms (median ~35 us). Tetris recordings
    showed a stall at each timer tick inside a note, on one grid across
    notes and rests.
    - Touch::Manual (counted) switches the touch FSM to software start with
    touch_pad_set_fsm_mode(), which on ESP32 also stops the timer
    (touch_ll_set_fsm_mode() alone left it running), and restores timer
    mode when the last one ends. ESP32 only.
    - Touch::measureNow() measures all pads once (~0.6 ms), but not more
    often than the timer would at the rate setUp() applied, so short
    notes don't each pay fo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
2026-11-09 touch: scale the threshold with the measure time
    The pad count grows with the measure time, so with _62ms a touched pad
    stays above the fixed threshold and never triggers (seen on the watch:
    menus dead, watchface fine). mSensitivity is now per _31ms unit and is
    multiplied by mCycles. No change with the current _31ms defaults. The
    measure rate only sets how often, it does not change the count.
    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
2026-11-12 speaker: Casio style hour beep, two equal short beeps at 4096 Hz
    The second beep of the hourly pattern lasted 500 ms. The hour beep and
    the menu test now share Peripherals::beep().
2026-11-13 touch: beep feedback of the buttons on the menus
    Touch > Beep plays a short tick (Beep::beep) for each press on the
    menus. The speaker now plays one sound at a time, so the tick and the
    sound of the action don't fight for the LEDC timer, and the chime
    previews wait a bit after it.
2026-11-13 speaker: Roman beep with two symbols, 10 is two long beeps
    X was a long tone like V an octave lower, hard to tell apart. Now I is
    short and V long at the same pitch: 9 is IVV, 10 VV, 12 VVII.
2026-11-13 ble: sync settings with the phone app during the display refresh
    - The watch is the BLE central: on full wakes, when the auto interval
    has passed, it scans while the display refreshes and gives up when the
    refresh ends unless the phone was heard (1.2 s cap)
    - Auto: Off, 5min, 15min, 1h, 6h. From 1h it rides on touches and the
    hourly full wake; under an hour it schedules its own full wakes (not
    at night or under 10% battery). Early wakes are capped at the hour
    - The phone's advertisement flags skip the connection when neither side
    has news; otherwise connect, encrypt, read the app's changes, write the
    watch values, disconnect. App changes apply after the draw and redraw
    - Pairing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
2026-11-13 settings: one table and one format for RTC, flash and the phone app
    - settings_table.cpp (was remote_settings.cpp) lists every persistent
    setting once; kApp entries go to the app, the rest (RTC calibration,
    touch map and cycles, battery tuning, alarms) are stored only
    - One record encoding everywhere: id u8, length u8, data. Numbers are
    1/2/4 byte LE, small structs raw with a check. Unknown ids and wrong
    lengths are skipped and numbers clamped, so blobs from other firmware
    versions still load
    - Flash: loaded on a cold boot; saved at the end of a full wake when an
    hour passed since the last check and the CRC changed. Other wakes
    only compare a time
    - storage.cpp wraps NVS for th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
2026-11-13 android: never remove another device's bond, pairing again goes through Forget
    - The GATT server reports every LE link of the phone: the device remembered for
    a half done pairing could be the headphones, and the next pairing removed
    their bond. Now only the device that sent the pairing request, and only if it
    calls itself LightInk
    - No Pair again button: Forget watch, then Pair watch
    - Warning when Android no longer holds the bond with the watch
